jnsbyr/rotarydial/(commit log)

2019-04-18 Revert back to pre-power-down.
    [main.c]
2019-04-26 Revert "Use PB2 (for INT0 in the future) for PIN_DIAL."
    This reverts commit 1fe569d6adce46ab46279dd2c09af8ca3fcaff58.
    [main.c]
2019-05-01 Set prescaler to 2. I'm not sure why this does not affect PWM.
2019-05-01 Revert "Set prescaler to 2. I'm not sure why this does not affect PWM."
    This reverts commit 6a1c42e271492d31b92b3d7735a5291dba8c4fdc.
    [main.c]
2019-05-01 Added .gitignore and arduino sketch.
2019-05-01 Use SLEEP_MODE_IDLE to replace WDT with TIMER1.
    [main.c]
2019-05-02 Replace and commented out WDT related code.
    [main.c]
2019-05-04 Added loop count limit when checking dial pin down.
2019-05-04 set pin->changed to false when no change occurs.
2019-05-04 set initial logic of the pulse pin to low.
2019-05-05 Don't play with GIMSK in ISR to avoid race condition.
    [dtmf.c, main.c]
2020-02-02 reenabled special dial functions, serveral fixes and enhancements
    - special dial functions reenabled
    - new special dial function "cancel"
    - reverse dialing reenabled
    - support * and # for redial
    - save redial in RAM and speed dial in EEPROM after last digit was dialed
    - place ATtiny output pin into high impedance mode when no tone is generated
    - configurabe oscillator
    [dtmf.c, dtmf.h, main.c]
